rookidroid/smarty/README.md

#  Smarty

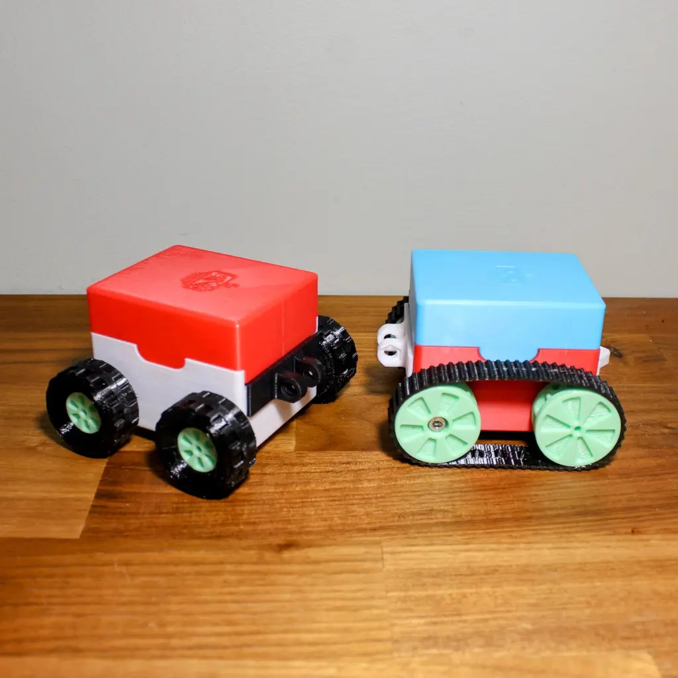
[picture p1: imgs/smarty_1.webp]
smarty_1
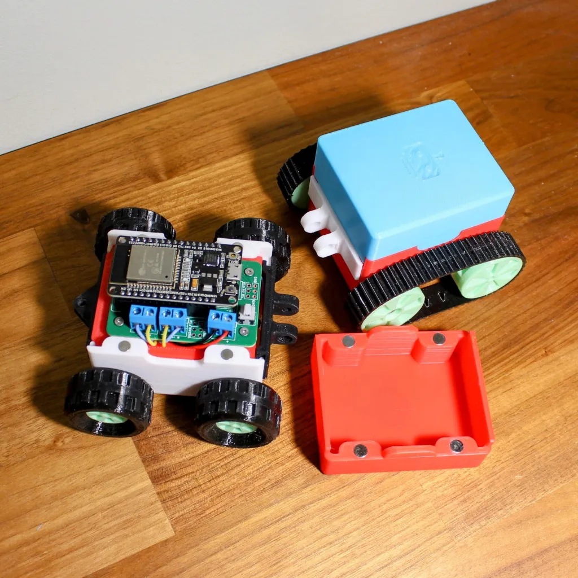
[picture p2: imgs/smarty_2.webp]
smarty_2


## Overview

This compact, remote-controllable robot car features a lightweight 3D-printed chassis, making it both durable and customizable. Powered by a 9V battery and driven by an ESP32 development board, the car supports wireless control via Wi-Fi. Perfect for hobbyists and educational projects, it combines mobility, smart control, and DIY engineering in one sleek package.

## Mechanism

### 3D-Printed Parts

| Filename | Thumbnail | Required # | Note |
| --- | --- | --- | --- |
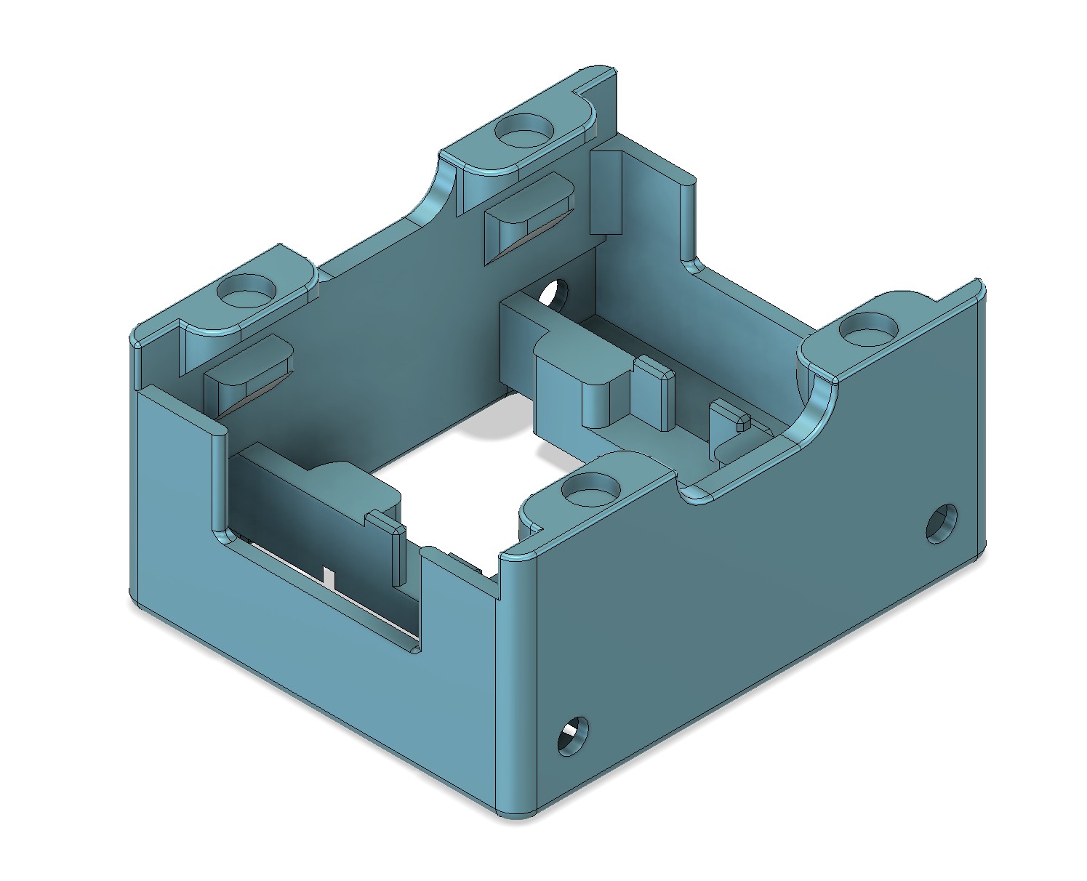
[picture p3: imgs/chassis.jpg]
chassis
| chassis |  | 1 | 8 x [6mm (diameter) x 2mm (thickness)] magnets |
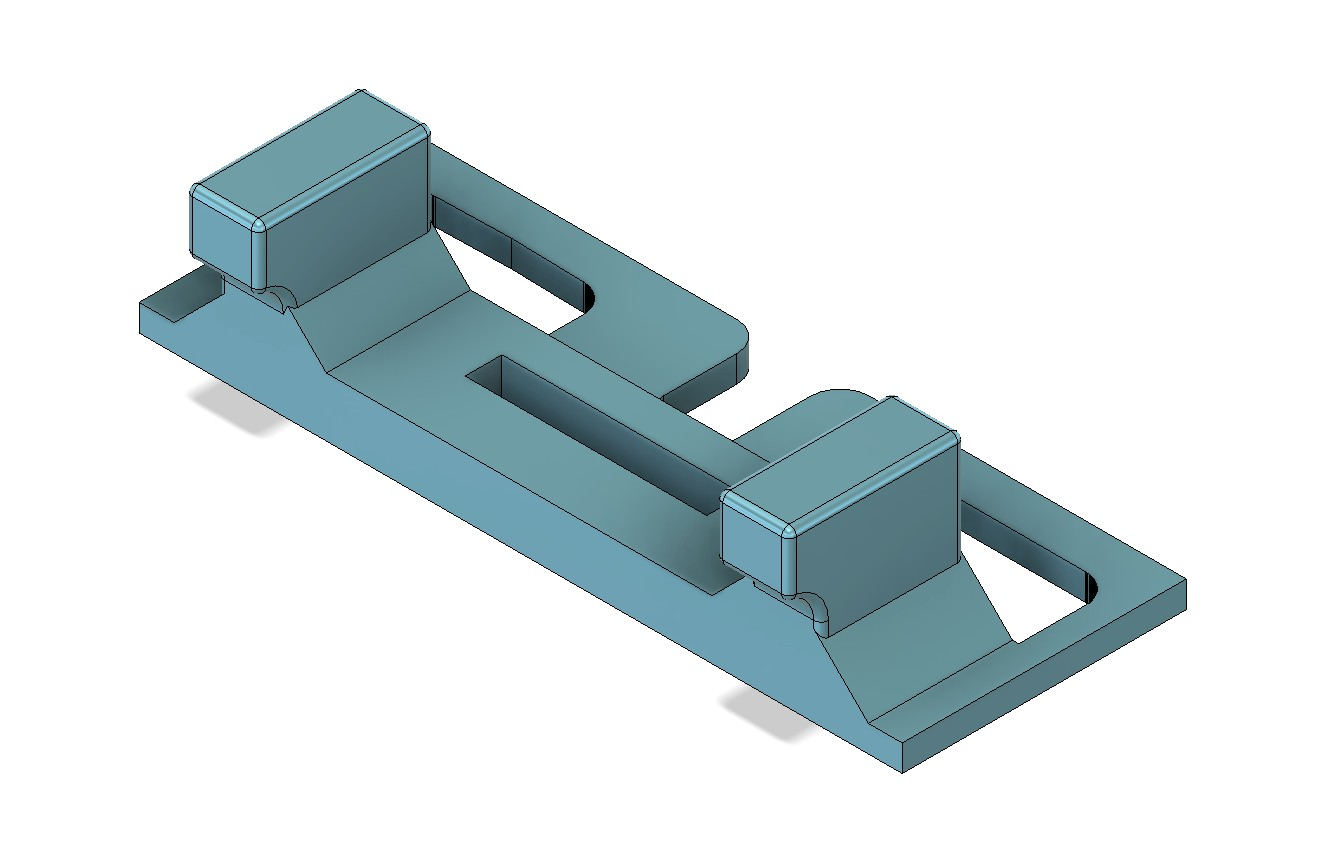
[picture p4: imgs/motor_cover.jpg]
motor_cover
| motor_cover |  | 2 | |
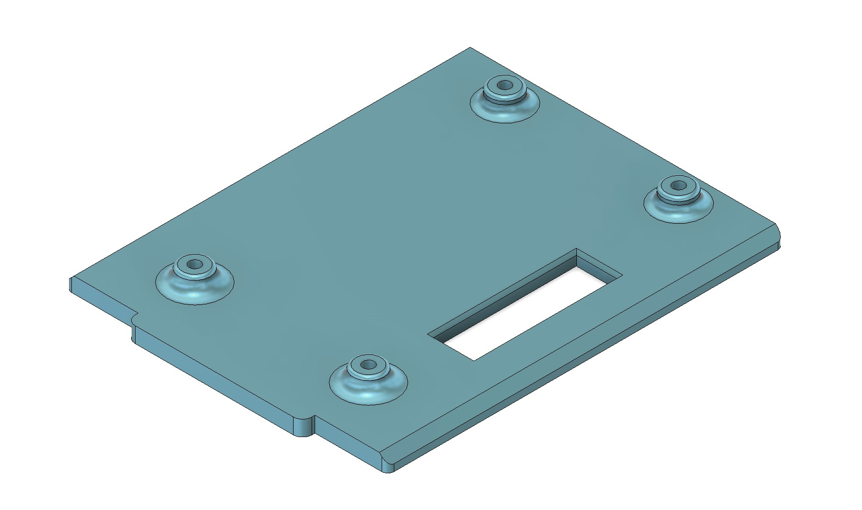
[picture p5: imgs/pcb_holder.jpg]
pcb_holder
| pcb_holder |  | 1 | |
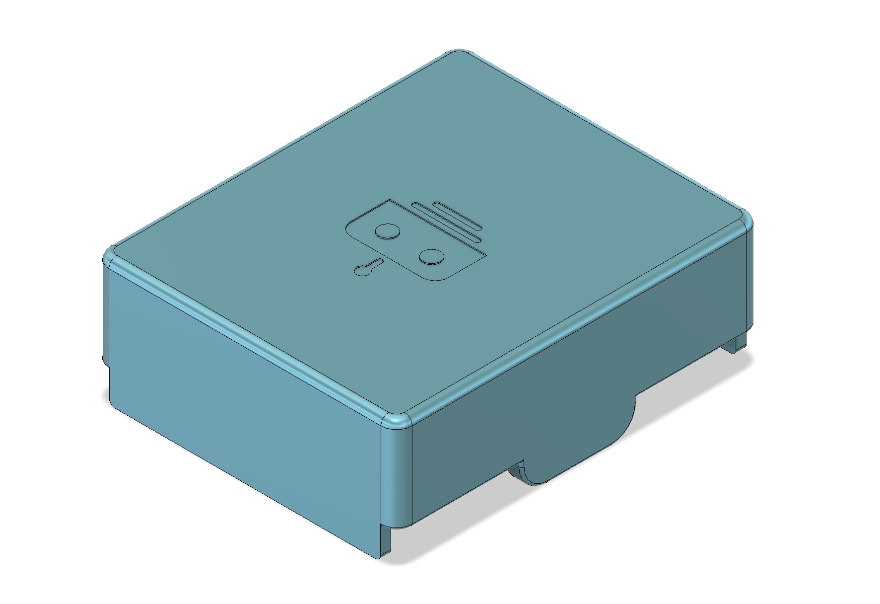
[picture p6: imgs/top_cover.jpg]
top_cover
| top_cover |  | 1 | 4 x [6mm (diameter) x 2mm (thickness)] magnets |
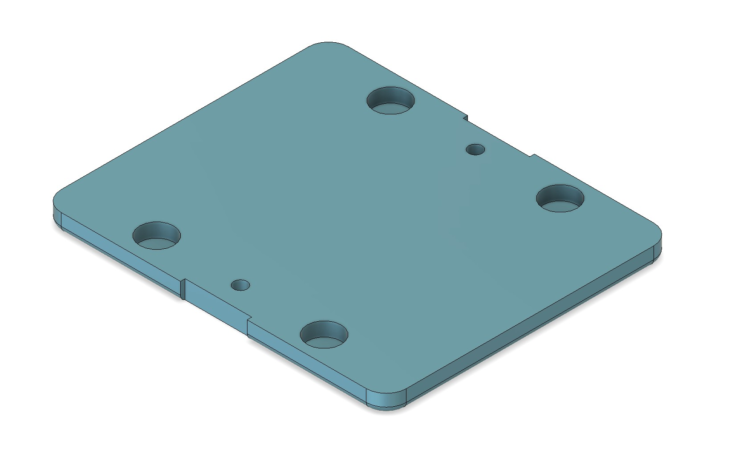
[picture p7: imgs/battery_cover.jpg]
battery_cover
| battery_cover |  | 1 | 4 x [6mm (diameter) x 2mm (thickness)] magnets |
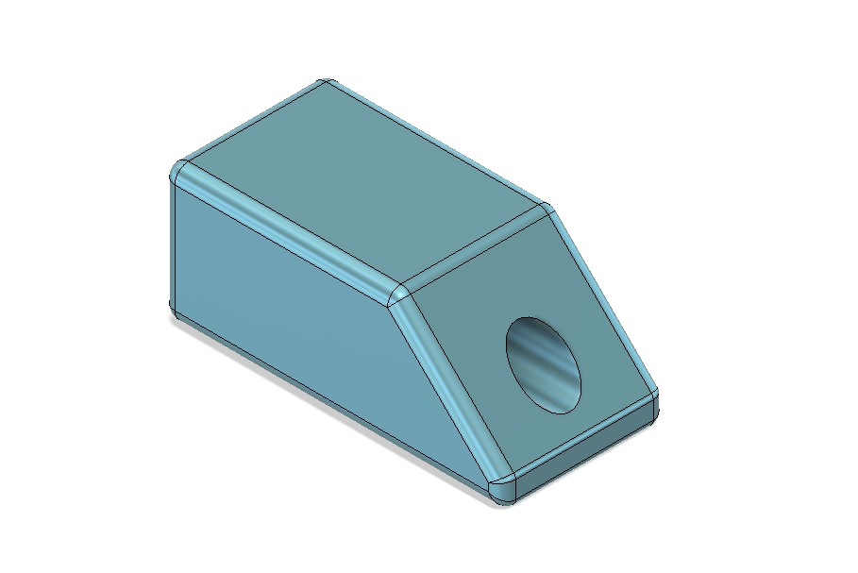
[picture p8: imgs/fill_block.jpg]
fill_block
| fill_block |  | 0 or 2 | Same numbers as slave wheels |
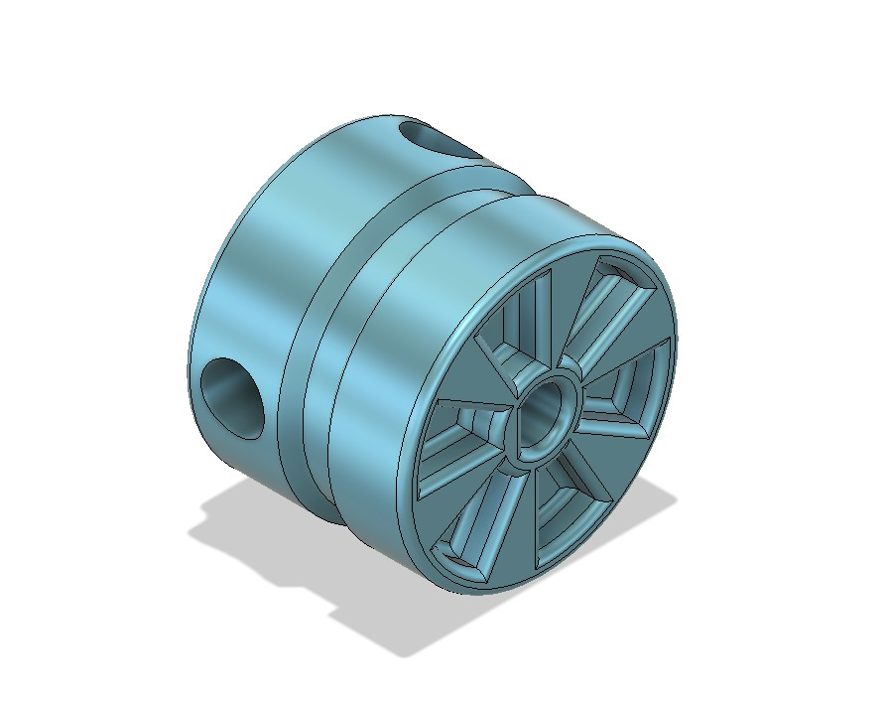
[picture p9: imgs/wheel_master.jpg]
wheel_master
| wheel_master |  | 4 or 2 | 4-wheel drive or 2-wheel drive |
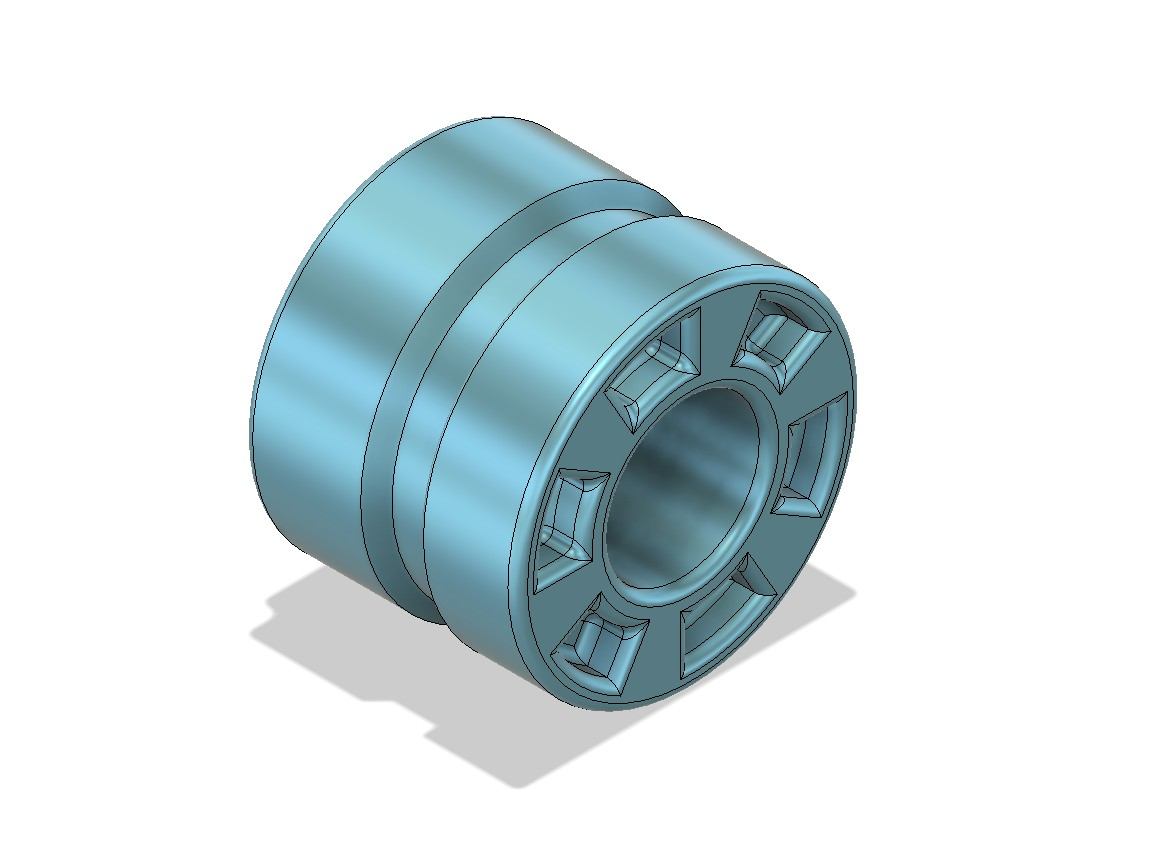
[picture p10: imgs/wheel_slave.jpg]
wheel_slave
| wheel_slave |  | 0 or 2 | 4-wheel drive or 2-wheel drive |
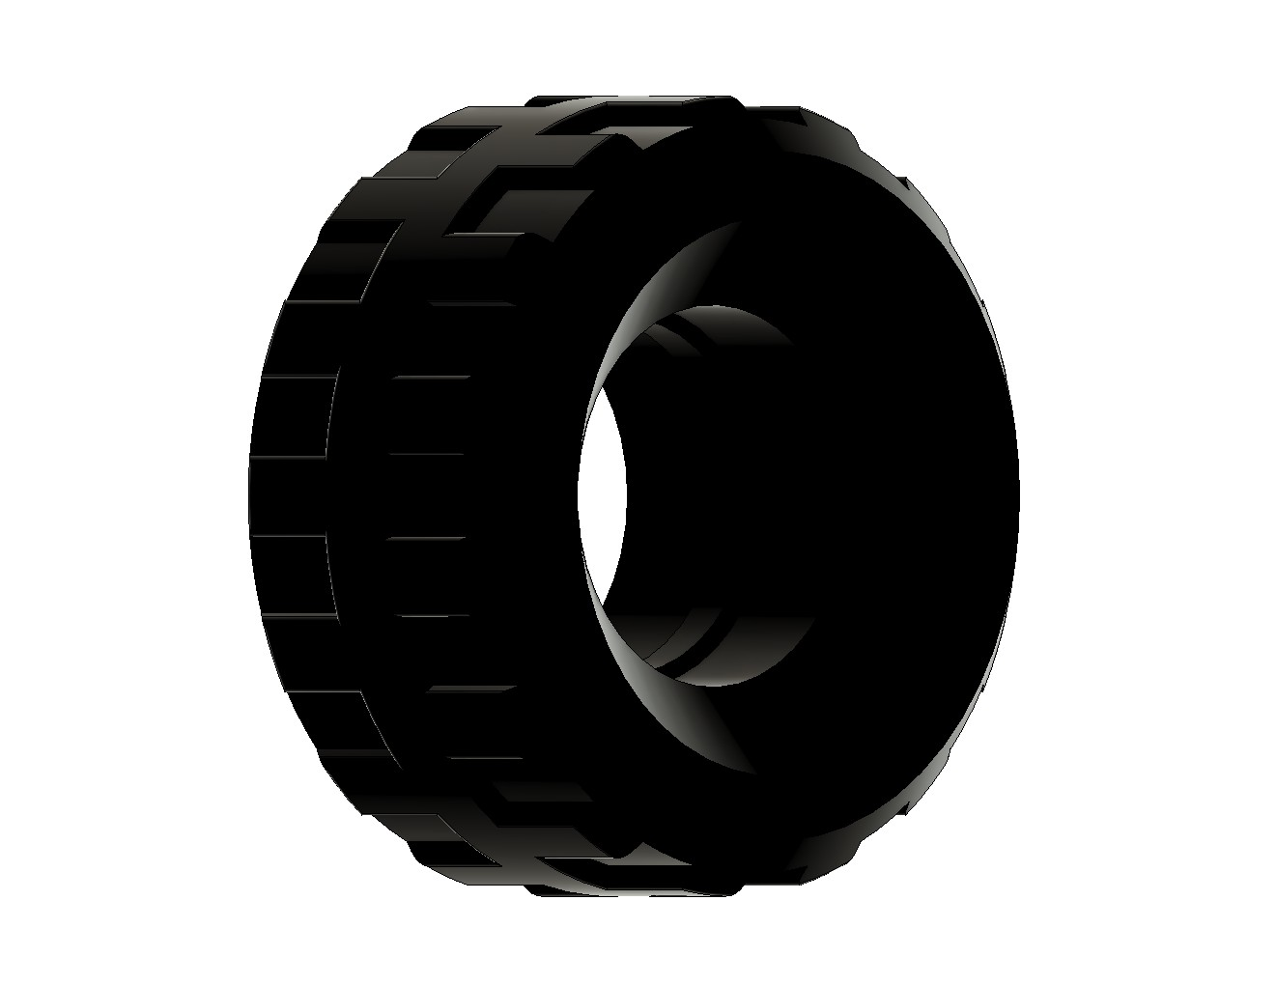
[picture p11: imgs/tire.jpg]
tire
| tire |  | 4 | Print with TPU, compatible with Lego 56891 Tire 37 x 18R |
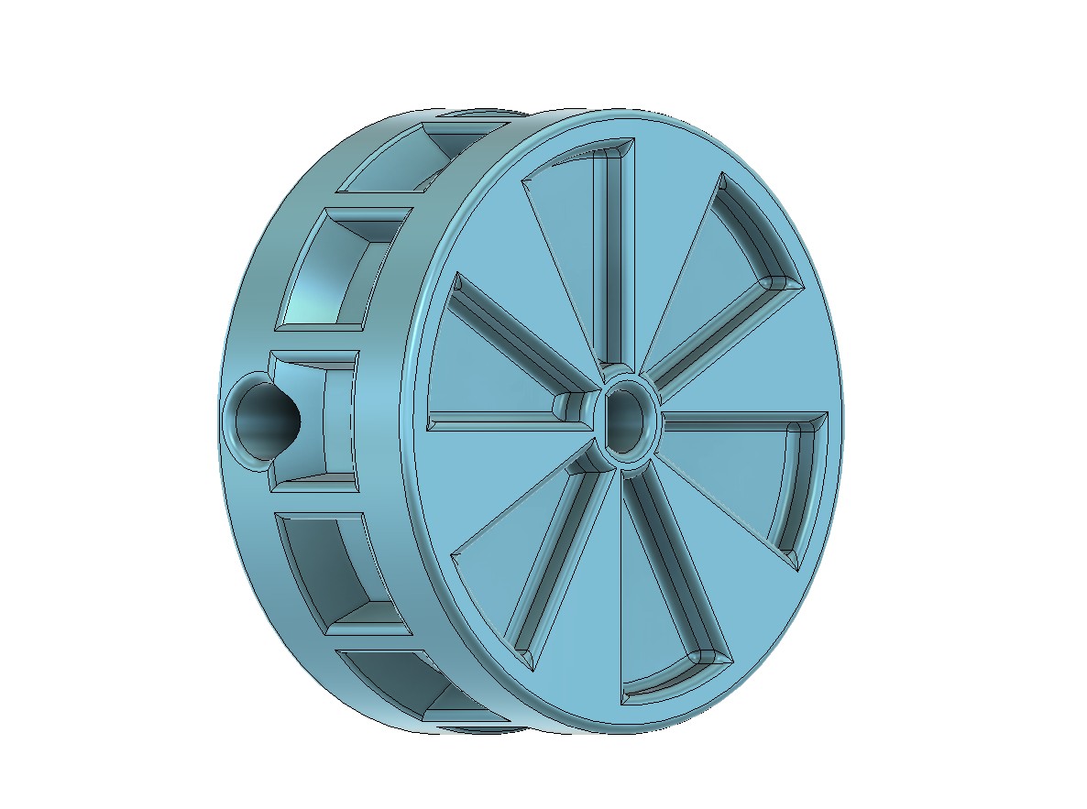
[picture p12: imgs/wheel_master_belt.jpg]
wheel_master_belt
| wheel_master_belt |  | 2 | |
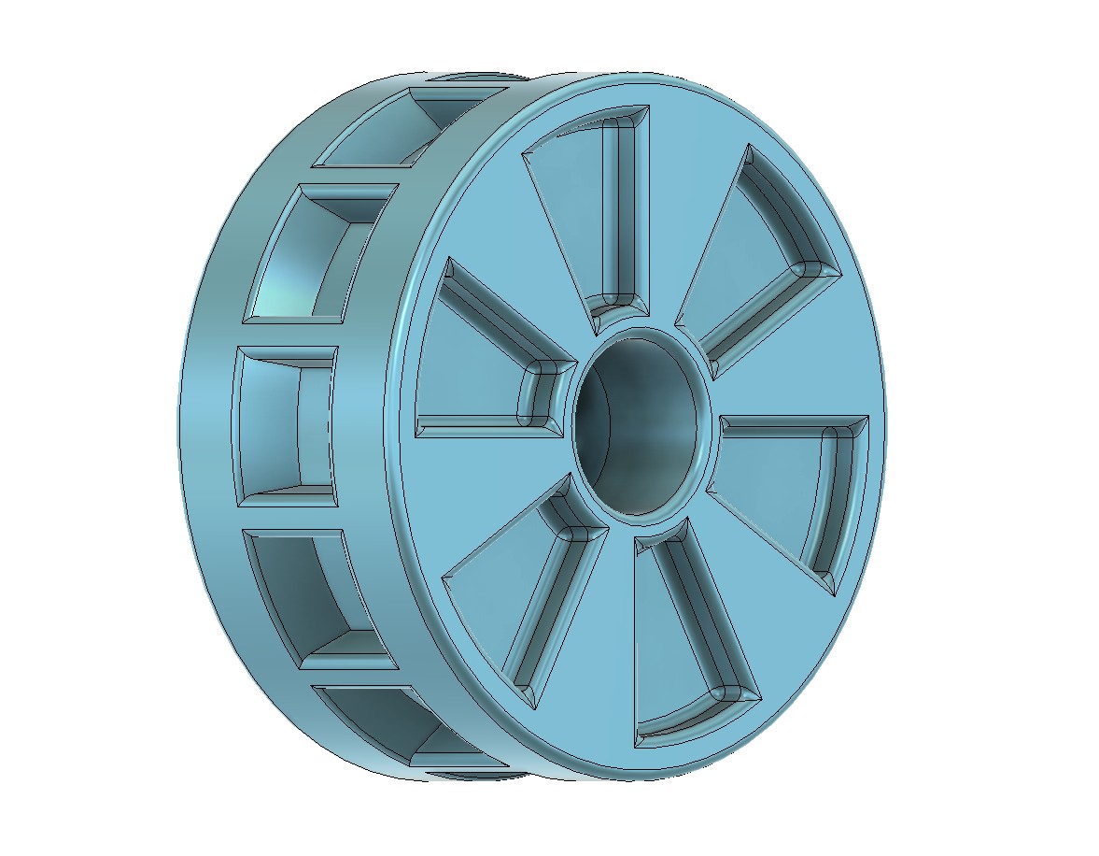
[picture p13: imgs/wheel_slave_belt.jpg]
wheel_slave_belt
| wheel_slave_belt  |  | 2 | |
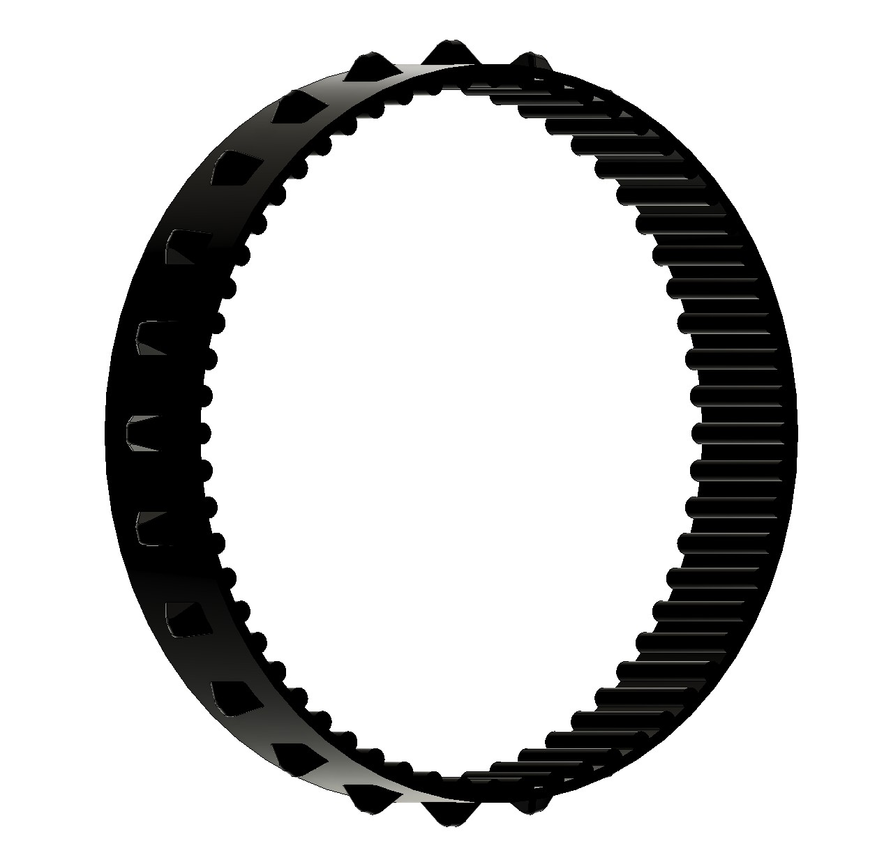
[picture p14: imgs/belt.jpg]
belt
| belt |  | 2 | Print with TPU |
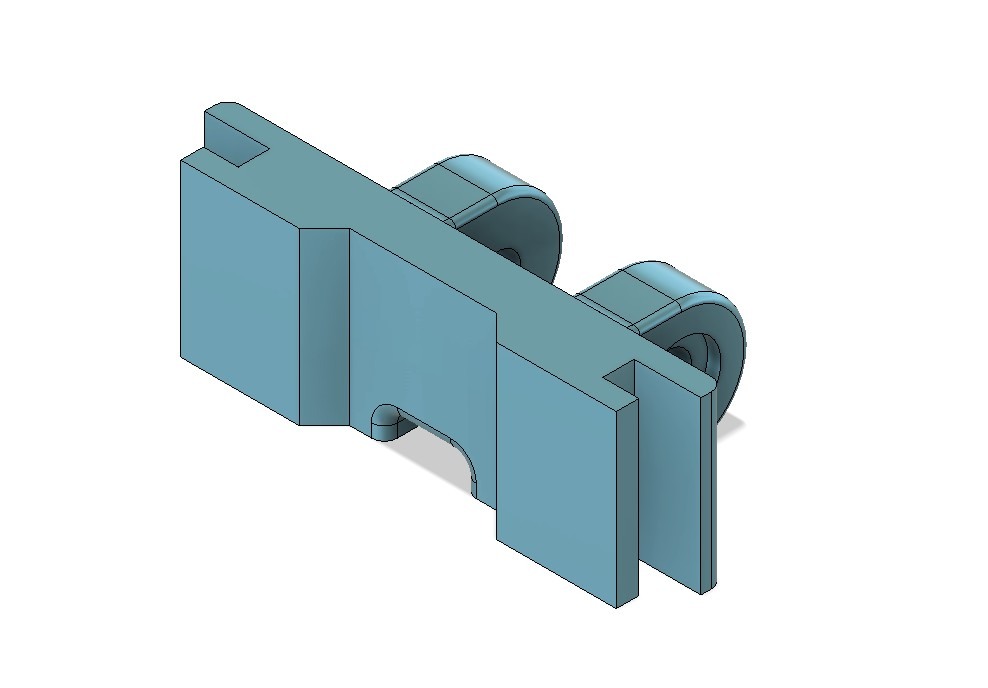
[picture p15: imgs/connector_front.jpg]
connector_front
| connector_front |  | 1 | |
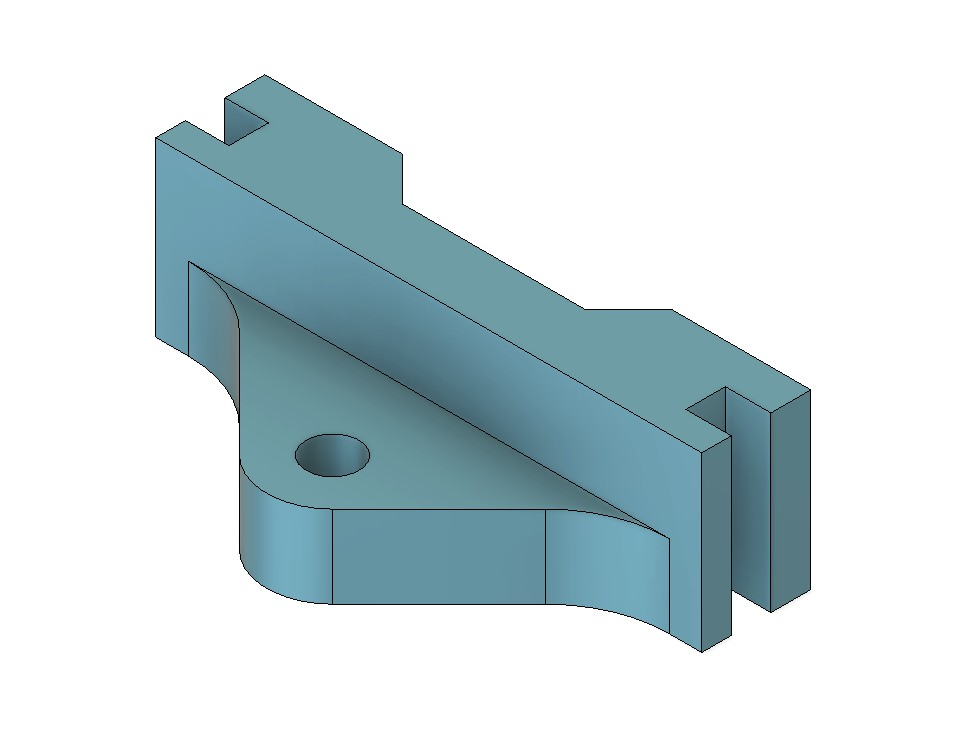
[picture p16: imgs/connector_trailer.jpg]
connector_trailer
| connector_trailer |  | 1 | |

## Software

### ESP32

- Install `esp32` in Arduino IDE's Boards Manager.
- Select `ESP32 Dev Module` for the board.
