rookidroid/smarty/imgs/pcb_diagram_smarty.png

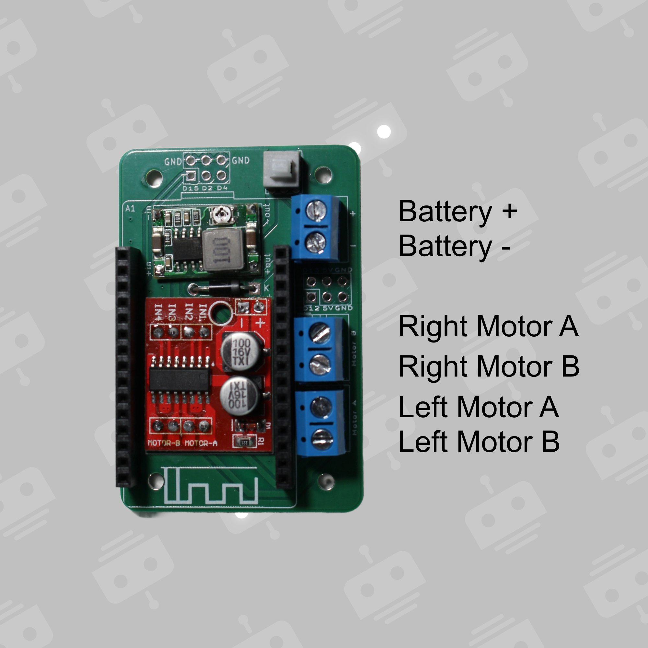
imgs/pcb_diagram_smarty.png
