rookidroid/smarty/imgs/smarty_model.jpg

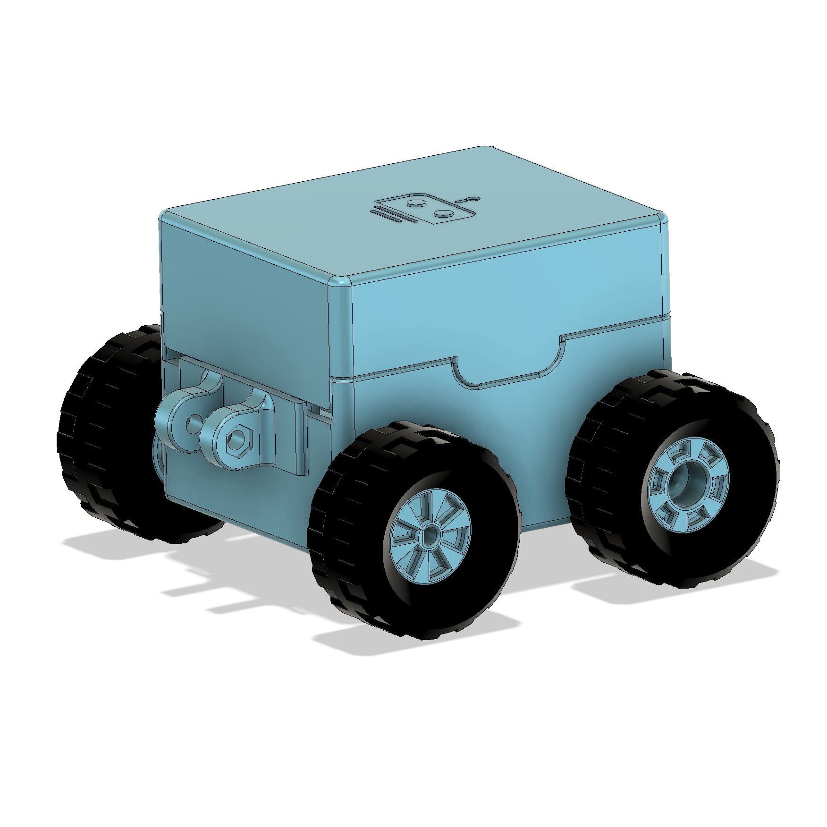
imgs/smarty_model.jpg
