rookidroid/smarty/model/accessories/connector_front.stl

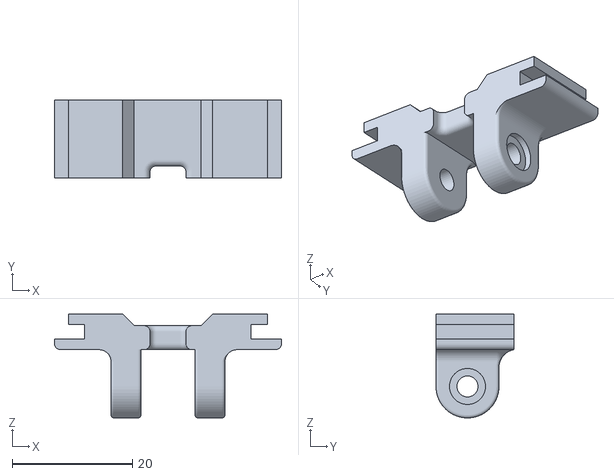
[picture p19: CAD file, 2025-05-16]
model/accessories/connector_front.stl
37.8 x 13.0 x 17.3
