rookidroid/smarty/model/body/chassis.stl

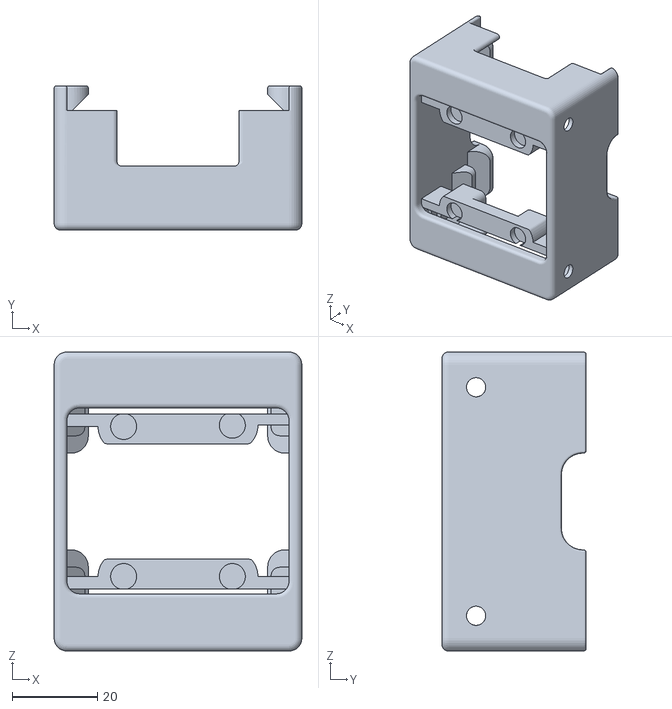
[picture p20: CAD file, 2025-05-16]
model/body/chassis.stl
58.0 x 33.8 x 70.0
