rookidroid/smarty/model/wheels/belt_flip.stl

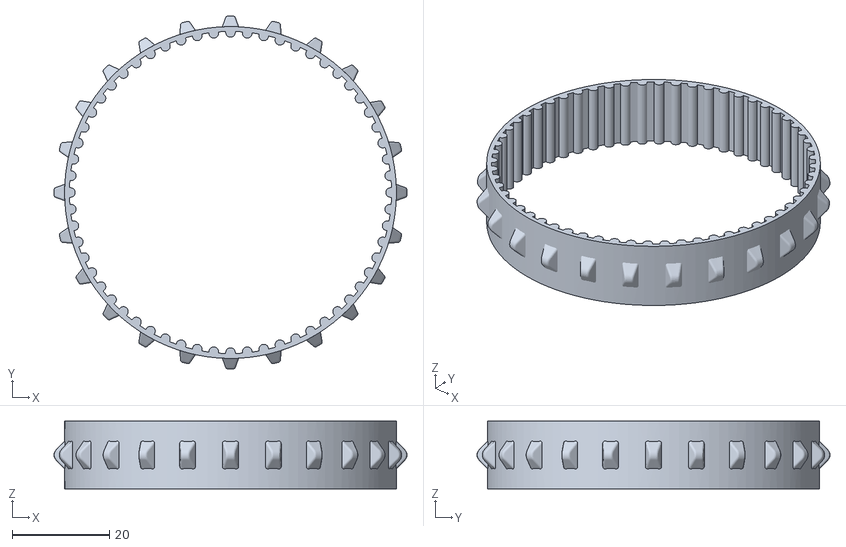
[picture p21: CAD file, 2025-05-16]
model/wheels/belt_flip.stl
72.8 x 72.8 x 14.0
