rookidroid/smarty/model/accessories/connector_trailer.stl

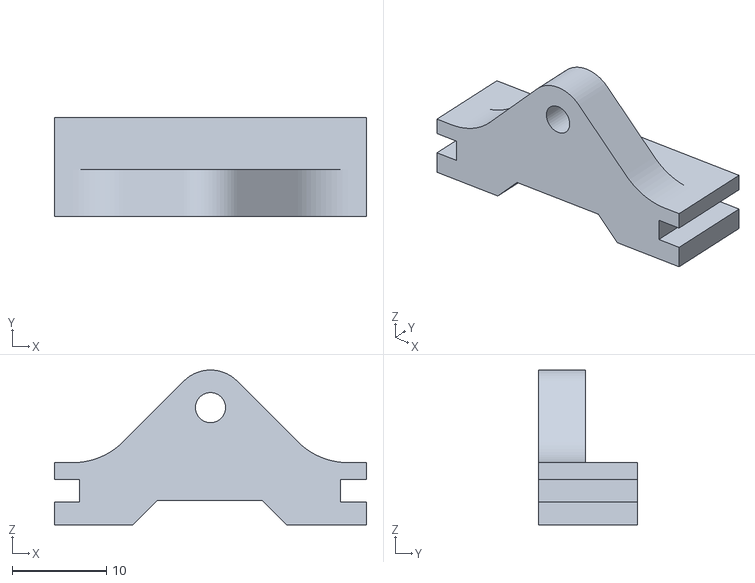
[picture p22: CAD file, 2025-05-16]
model/accessories/connector_trailer.stl
33.2 x 10.5 x 16.5
