rookidroid/smarty/model/body/motor_cover.stl

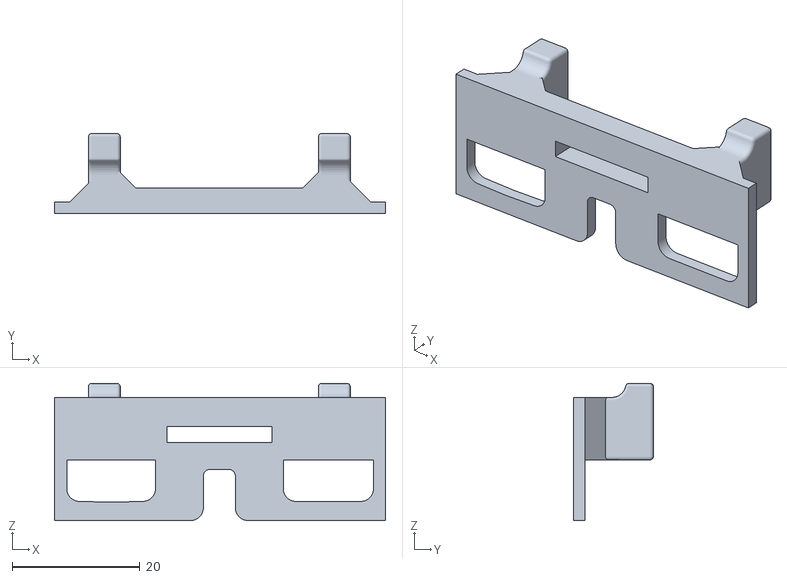
[picture p23: CAD file, 2025-05-16]
model/body/motor_cover.stl
51.8 x 12.5 x 21.5
