rookidroid/smarty/model/wheels/wheel_master.stl

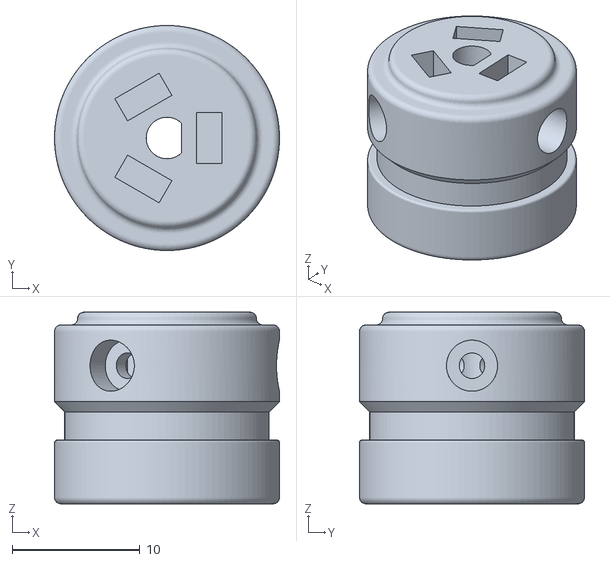
[picture p24: CAD file, 2025-05-16]
model/wheels/wheel_master.stl
17.6 x 17.6 x 15.0
