rookidroid/smarty/3d model/robot/retaining_ring.stl

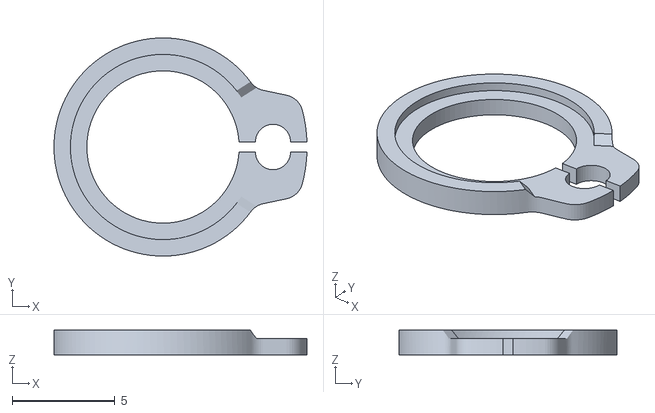
[picture p25: CAD file, 2021-10-22]
3d model/robot/retaining_ring.stl
12.3 x 10.6 x 1.20
