rookidroid/smarty/model/accessories/trailer.stl

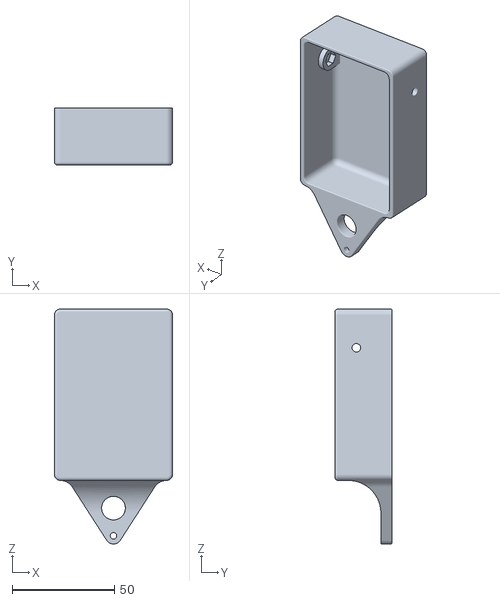
[picture p26: CAD file, 2025-03-29]
model/accessories/trailer.stl
58.0 x 28.0 x 115.2
