rookidroid/smarty/model/body/top_cover.stl

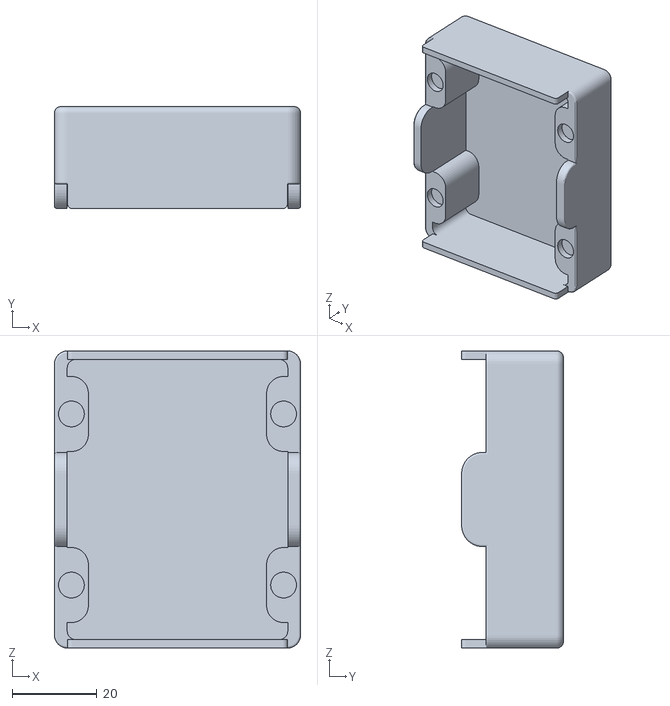
[picture p27: CAD file, 2025-05-16]
model/body/top_cover.stl
58.0 x 24.0 x 70.0
