rookidroid/smarty/model/wheels/tire.stl

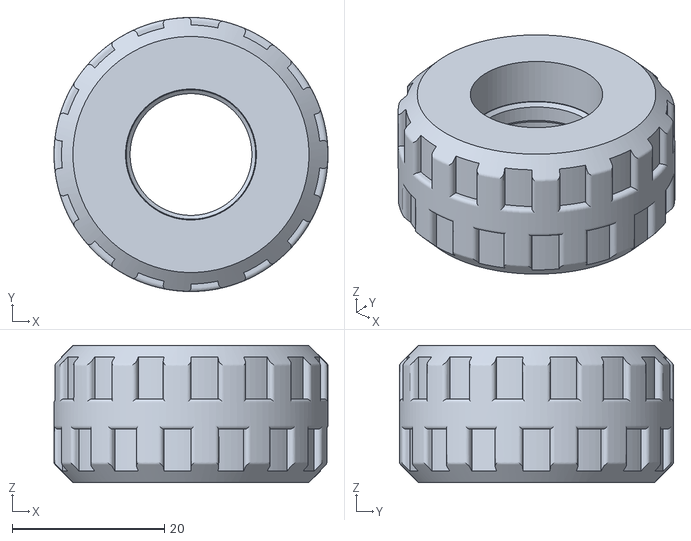
[picture p28: CAD file, 2025-05-16]
model/wheels/tire.stl
36.0 x 36.0 x 18.0
