rookidroid/smarty/model/body/pcb_holder.stl

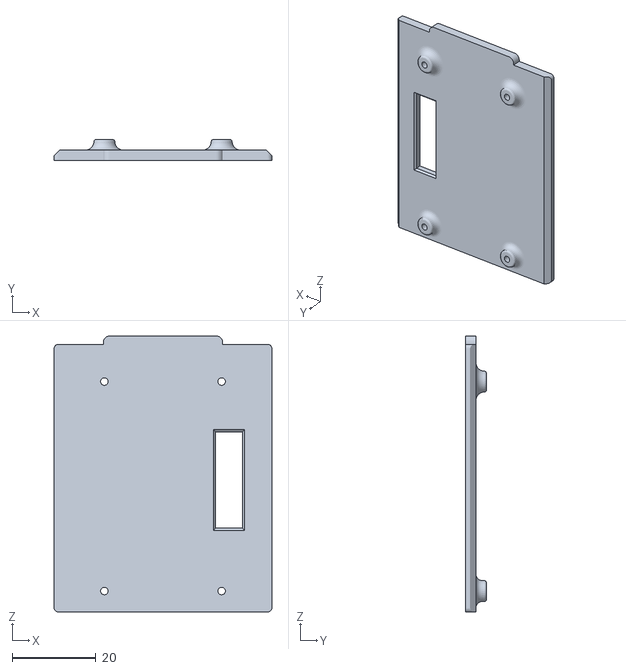
[picture p29: CAD file, 2025-05-16]
model/body/pcb_holder.stl
52.0 x 5.00 x 65.9
