rookidroid/smarty/model/wheels/wheel_slave.stl

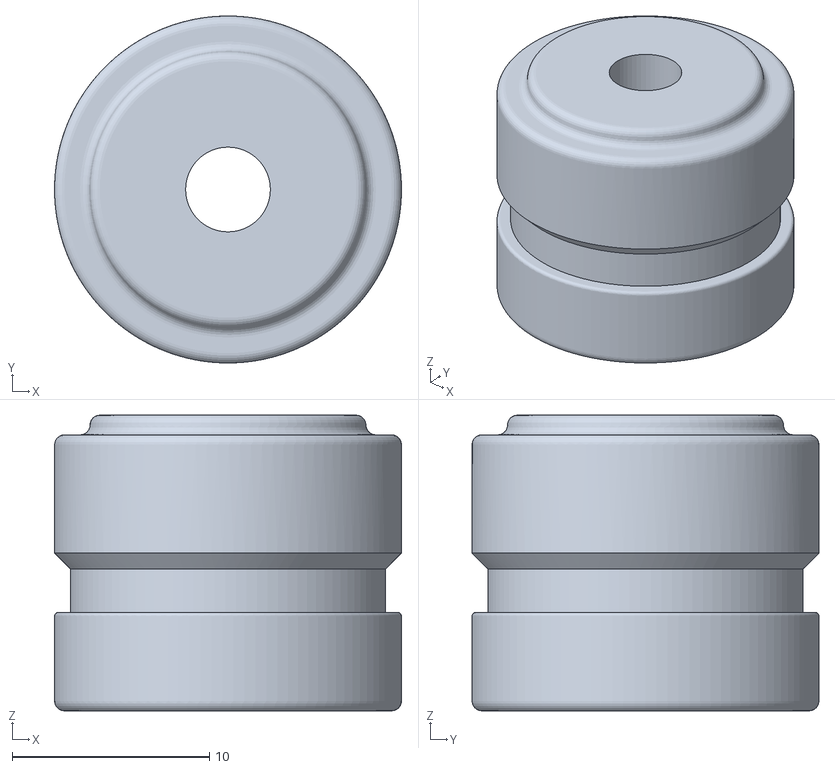
[picture p30: CAD file, 2025-05-16]
model/wheels/wheel_slave.stl
17.6 x 17.6 x 15.0
