rookidroid/smarty/model/body/fill_block.stl

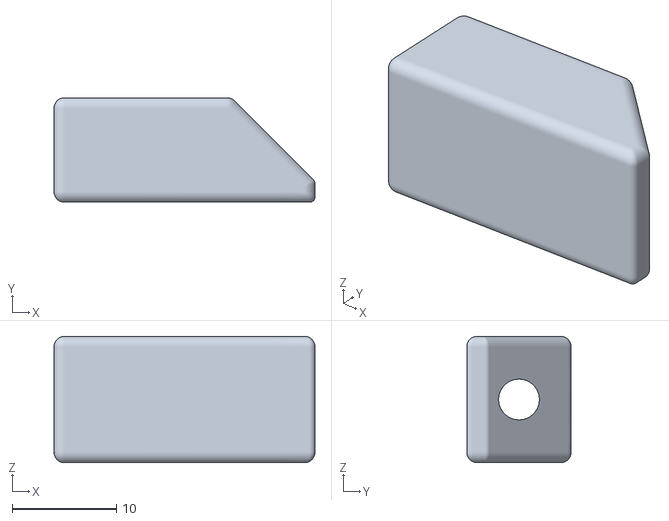
[picture p31: CAD file, 2025-03-29]
model/body/fill_block.stl
25.0 x 10.0 x 12.1
