rookidroid/smarty/model/wheels/wheel_belt_slave.stl

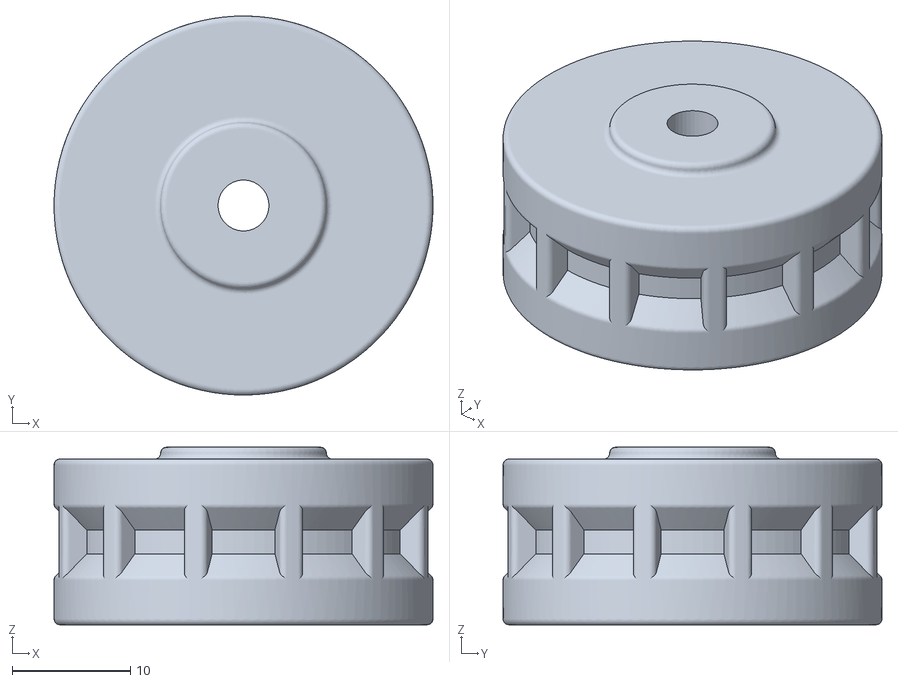
[picture p32: CAD file, 2025-05-16]
model/wheels/wheel_belt_slave.stl
32.0 x 32.0 x 15.0
