rookidroid/smarty/model/body/battery_cover.stl

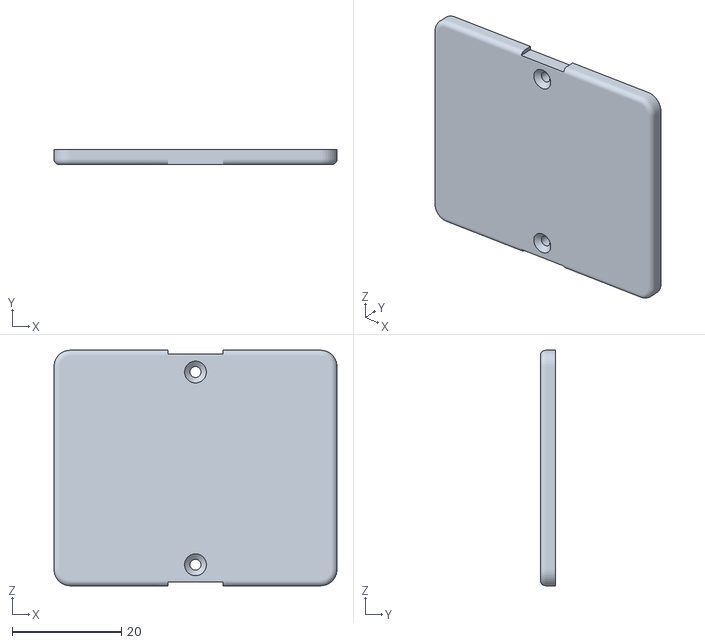
[picture p33: CAD file, 2025-03-29]
model/body/battery_cover.stl
51.8 x 2.80 x 43.1
