rookidroid/smarty/model/wheels/wheel_belt_master.stl

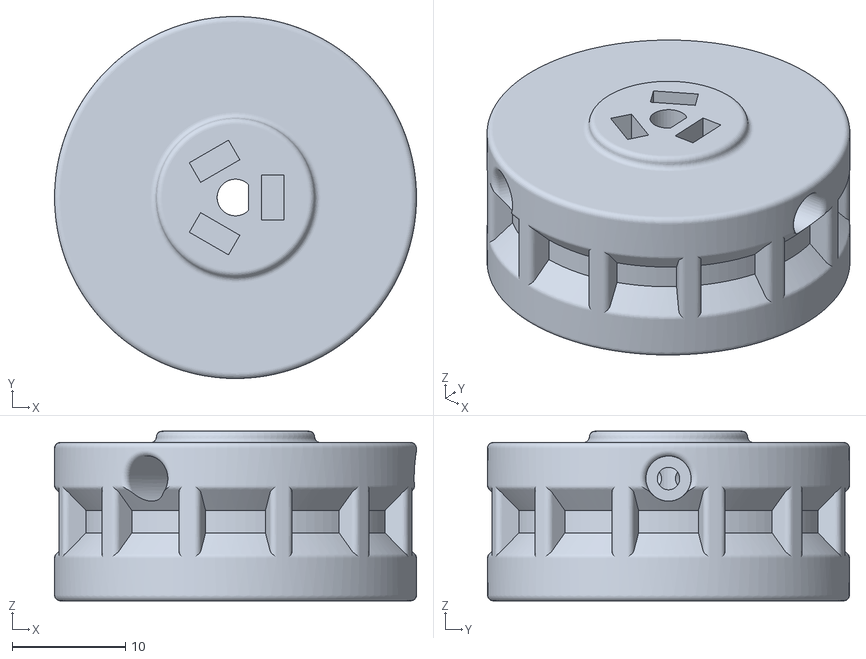
[picture p34: CAD file, 2025-05-16]
model/wheels/wheel_belt_master.stl
32.0 x 32.0 x 15.0
