rookidroid/smarty/3d model/robot/chassis.stl

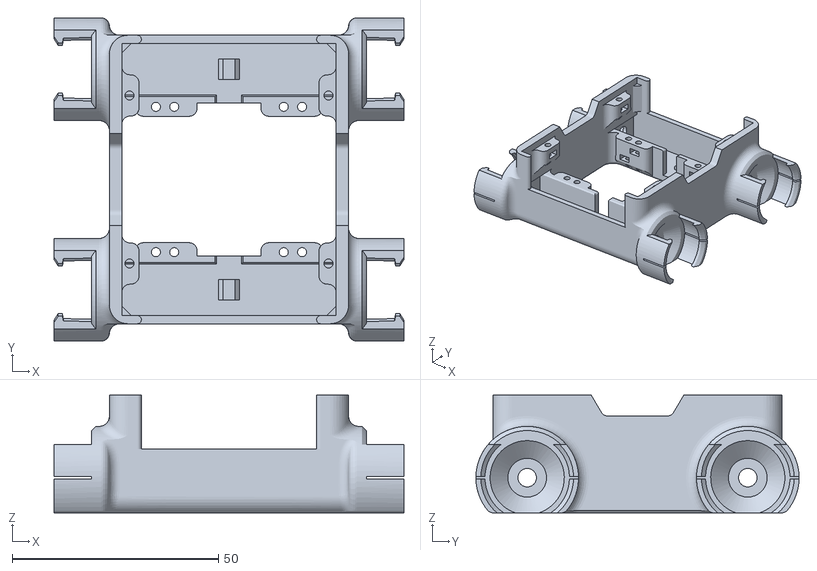
[picture p35: CAD file, 2023-05-29, an earlier design]
3d model/robot/chassis.stl
84.9 x 78.4 x 28.5
