rookidroid/smarty/3d model/robot/battery_cover.stl

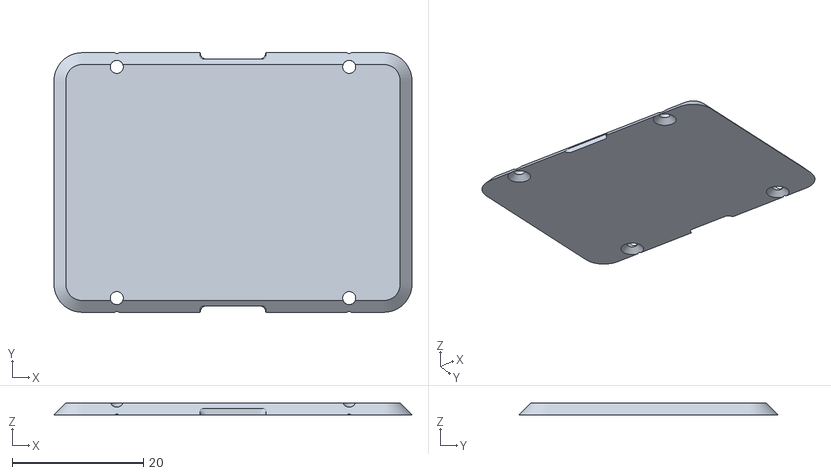
[picture p36: CAD file, 2023-05-29, an earlier design]
3d model/robot/battery_cover.stl
54.6 x 39.6 x 1.80
