rookidroid/smarty/(list of files, cad)

Other CAD files:
model/smarty.f3d
