rookidroid/smarty/imgs/assembly 1.png

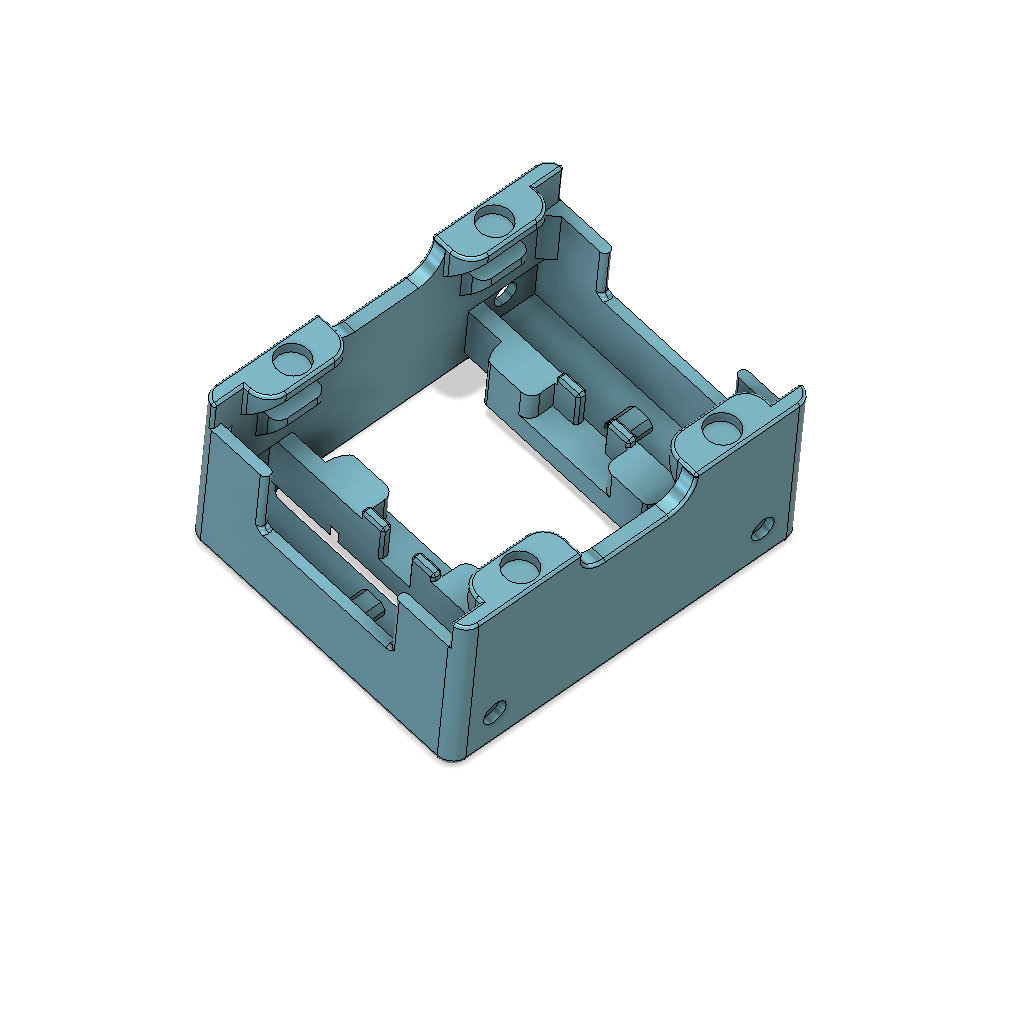
imgs/assembly 1.png
