rookidroid/smarty/imgs/assembly 6.png

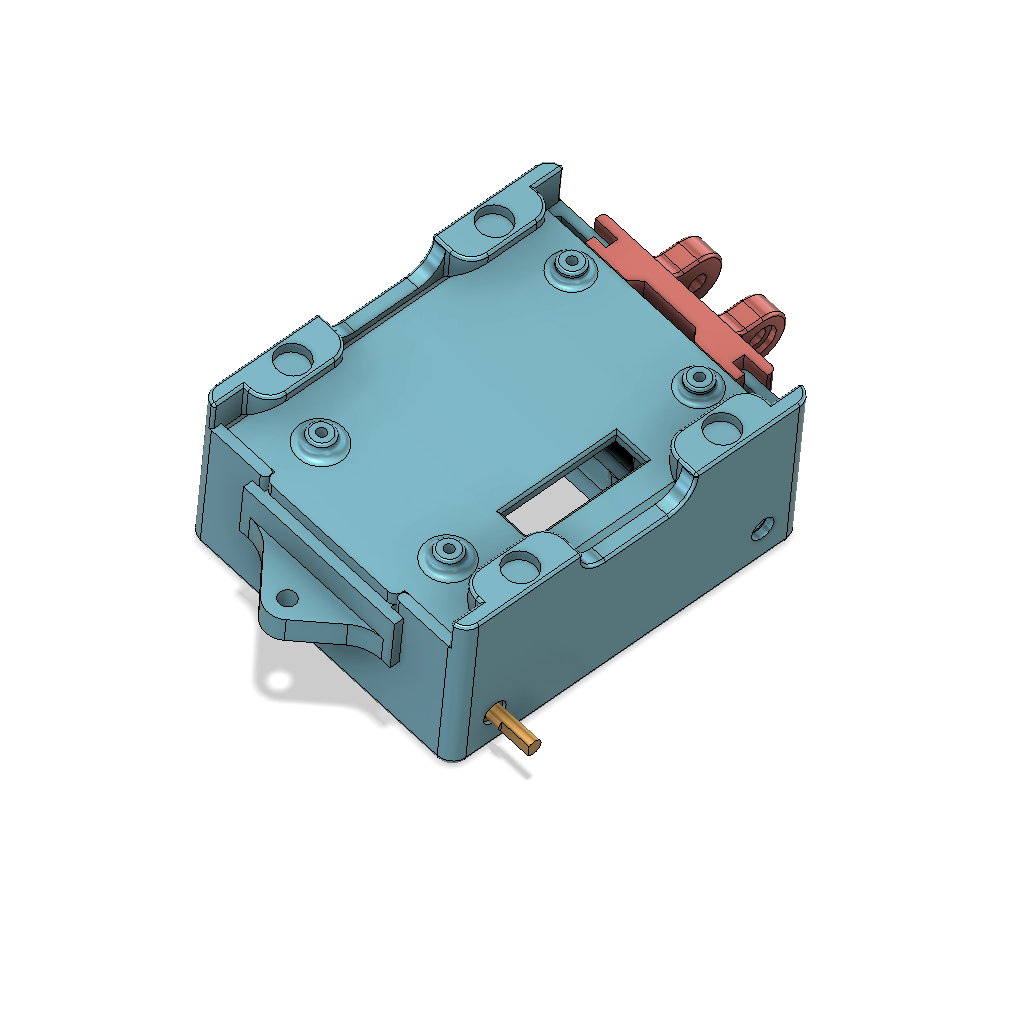
imgs/assembly 6.png
