rookidroid/smarty/imgs/assembly 7.png

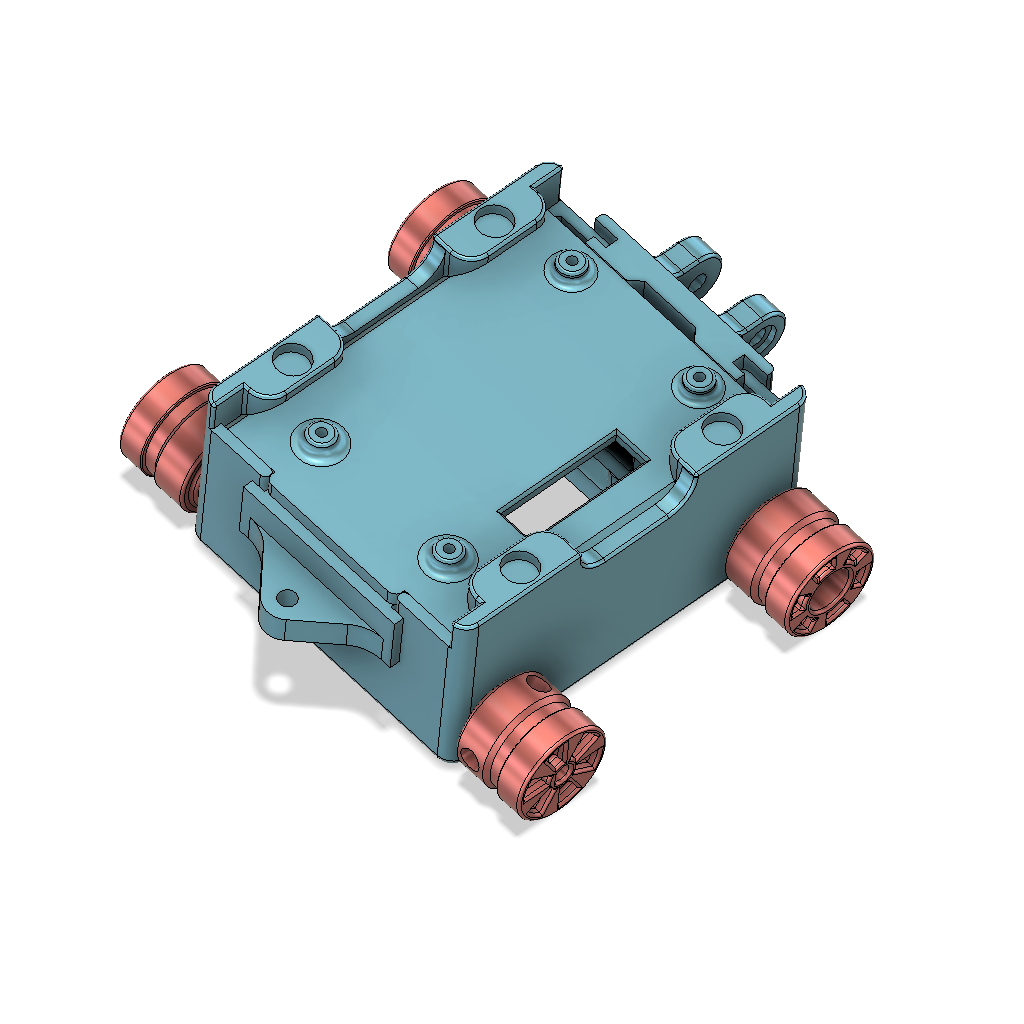
imgs/assembly 7.png
