rookidroid/smarty/imgs/assembly 8.png

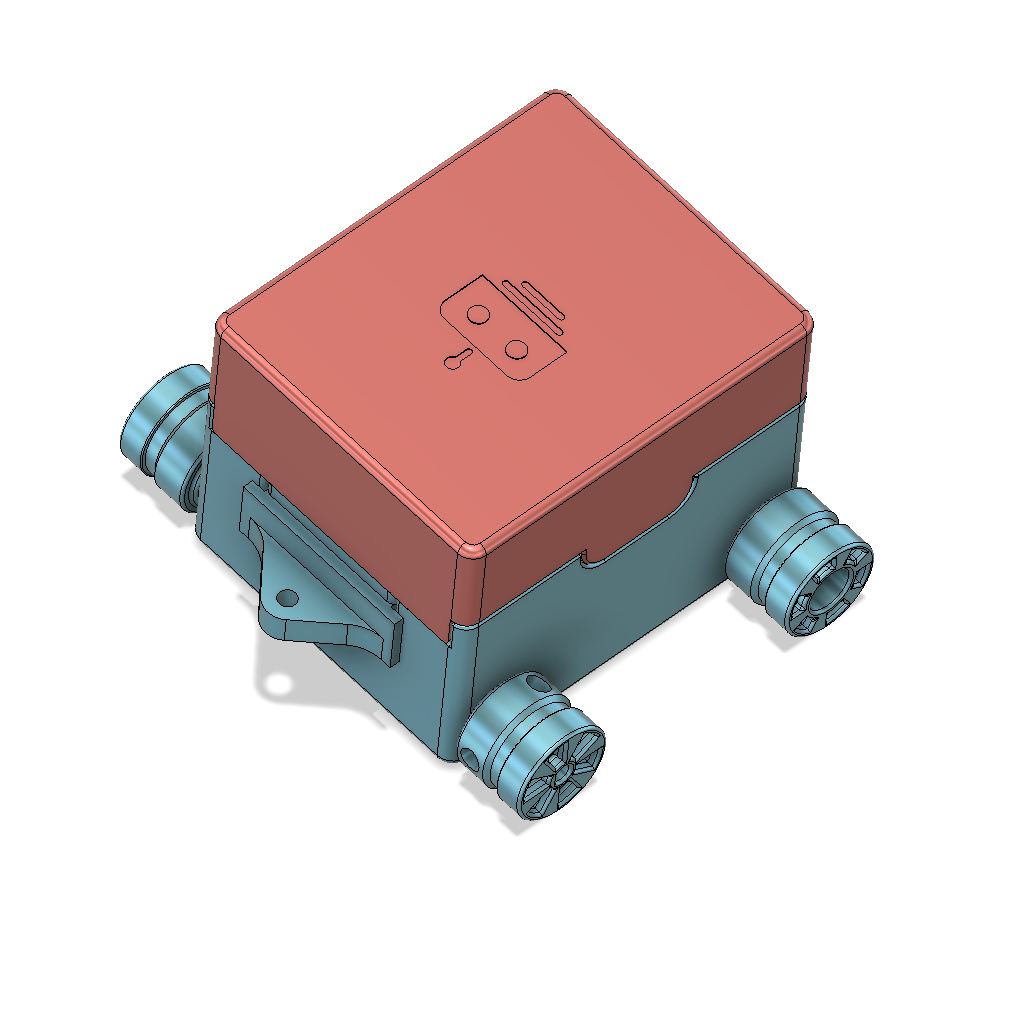
imgs/assembly 8.png
