rookidroid/smarty/imgs/assembly 9.png

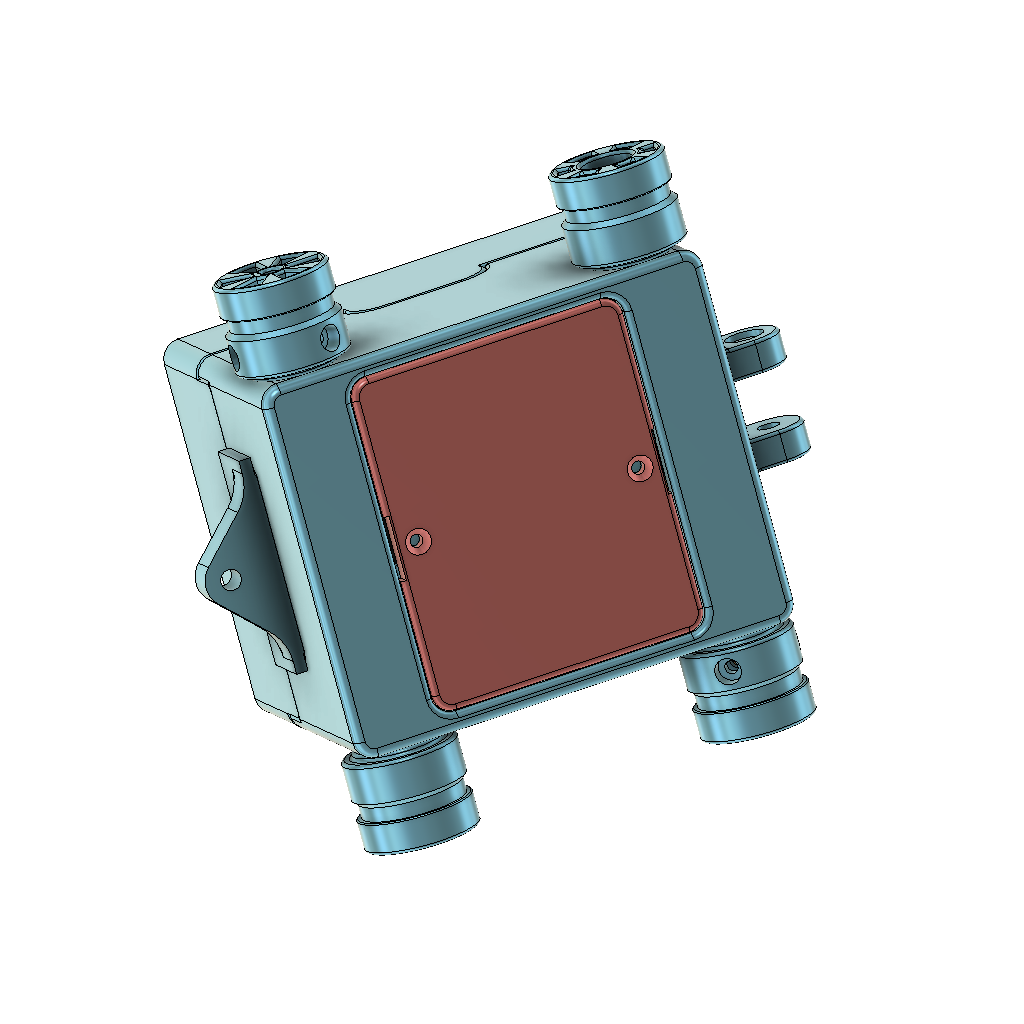
imgs/assembly 9.png
