rookidroid/smarty/imgs/assembly 10.png

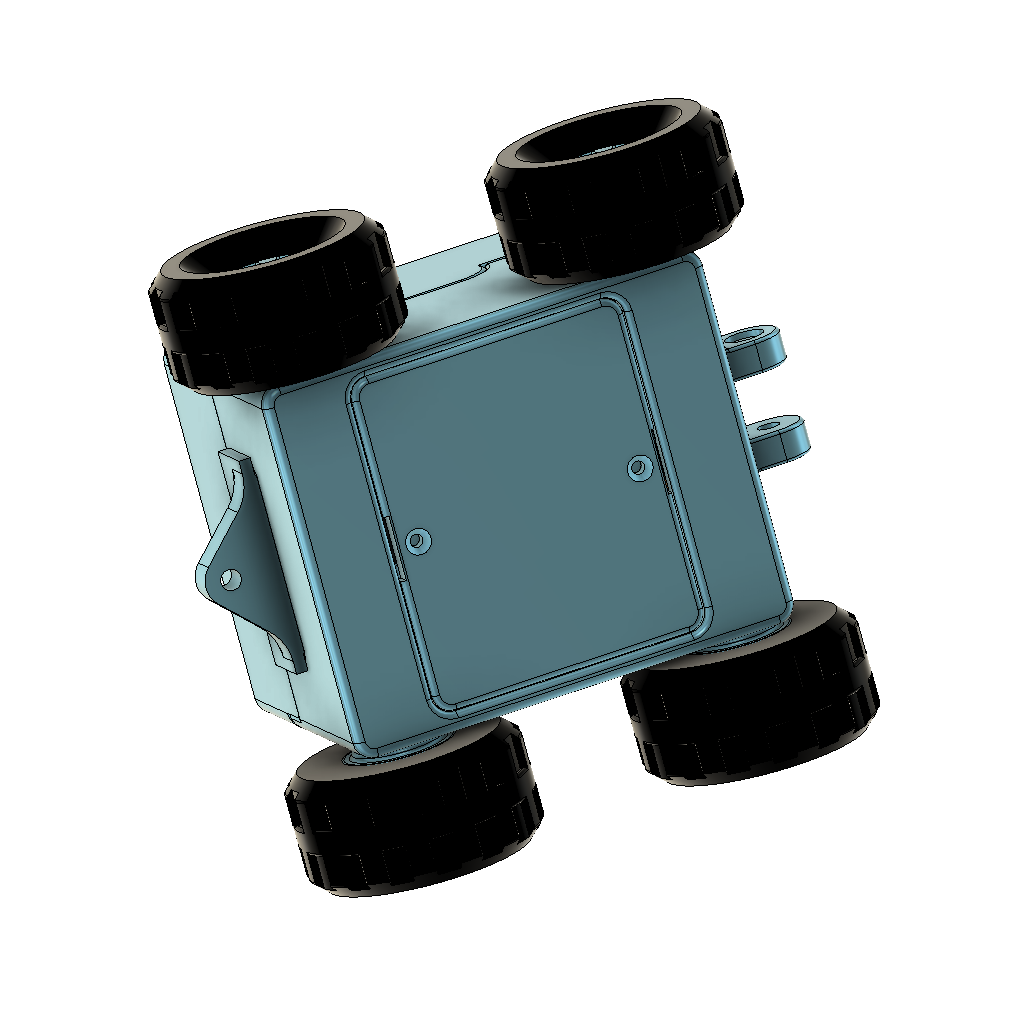
imgs/assembly 10.png
