rookidroid/smarty/(commit log)

2021-10-22 3d printer models
    [battery_cover.stl, chassis_608.stl, holding_board__9V.stl, mechanical_track.stl, motor_plug.stl, retaining_ring.stl, wheel_608.stl]
2022-11-27 update 3D model
    [battery_cover.stl, board.stl, chassis.stl, chassis_608.stl, connector.stl, cover.stl, eyes.stl, holding_board__9V.stl]
2023-05-29 v1.0
    stl files from remote controller
    stl files for the robot
    Delete motor_plug.stl
    Update README.md
    Update README.md
    update
    update
    Update README.md
    wheels
    update
    arcade controller
    [arcade body.stl, arcade cover.stl, battery_cover.stl, board.stl, board_holder.stl, bottom.stl, chassis.stl, connector.f3d]
2023-05-29 move arcade to its dedicated repo
    [arcade body.stl, arcade cover.stl, battery_cover.stl]
2023-05-29 Update connector (2).stl
    [connector (2).stl]
2024-05-29 update models
    [aggressive_eyes.stl, battery_cover.stl, board_holder.stl, chassis.stl, chassis_v2.stl, connector_a.stl, connector_led.stl, connector_v.stl]
2025-05-17 add pcb images
2025-06-19 Fix duty cycle calculation for left and right motors
    Swapped the offset_dutycycle addition/subtraction in left_duty and right_duty assignments to correct motor control logic.
    [smarty.ino]
